sladorsoft/Slador188/(commit log)

2023-11-28 Added Slador188 schematic prototype and the code for the "Pico as I/O device" video
    [Slador188.kicad_sch]
2024-10-11 Added sample programmes for "Raspberry Pi Pico Disk Controller" video.
